ufrs12/OLTA-PCB-ROLL-CUTTER/3d/cutter/Подшипник 608.FCStd

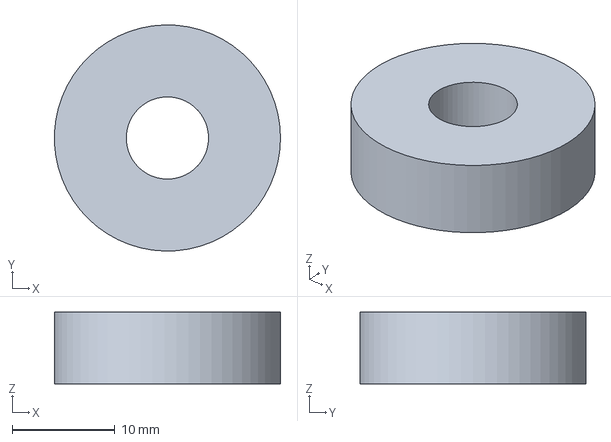
[picture p9: CAD file, 2025-05-30]
3d/cutter/Подшипник 608.FCStd
22.0 x 22.0 x 7.00 mm
