ufrs12/OLTA-PCB-ROLL-CUTTER/3d/machine/Опора.FCStd

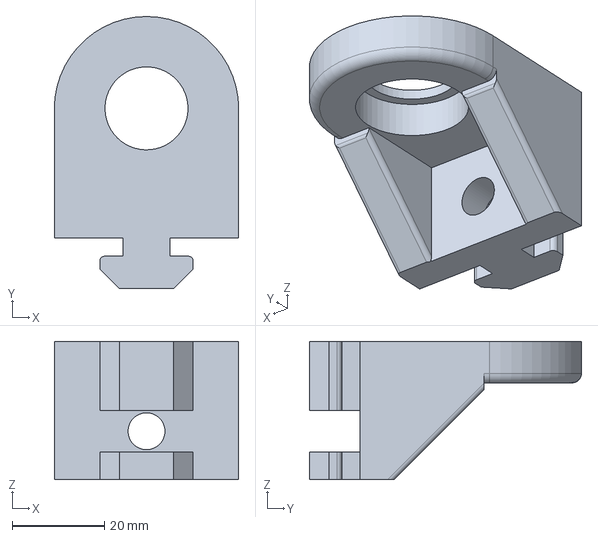
[picture p10: CAD file, 2025-05-30]
3d/machine/Опора.FCStd
40.0 x 59.0 x 30.0 mm
