ufrs12/OLTA-PCB-ROLL-CUTTER/3d/cutter/Тюрючек.FCStd

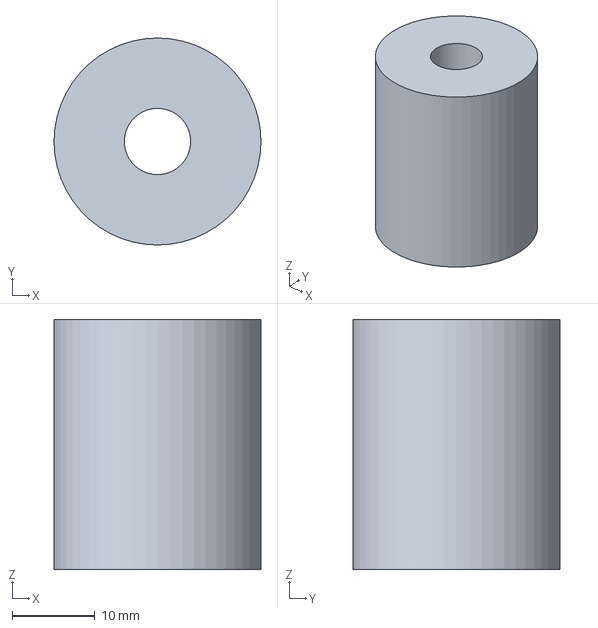
[picture p11: CAD file, 2025-05-30]
3d/cutter/Тюрючек.FCStd
25.0 x 25.0 x 30.2 mm
