ufrs12/OLTA-PCB-ROLL-CUTTER/3d/cutter/Прижим лезвия.FCStd

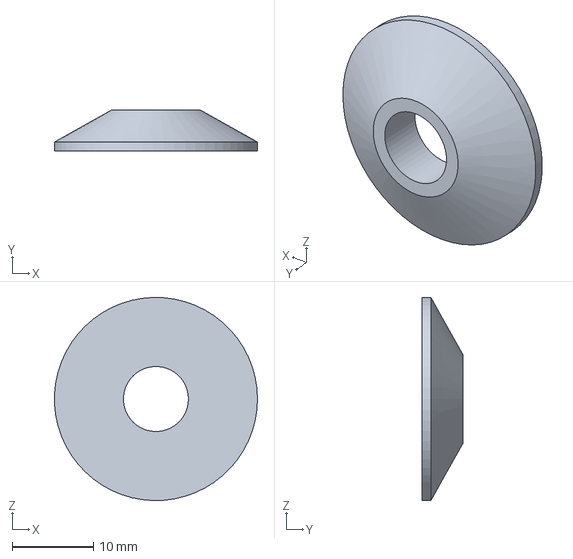
[picture p12: CAD file, 2025-05-30]
3d/cutter/Прижим лезвия.FCStd
25.0 x 5.00 x 25.0 mm
