ufrs12/OLTA-PCB-ROLL-CUTTER/3d/cutter/Лезвие.FCStd

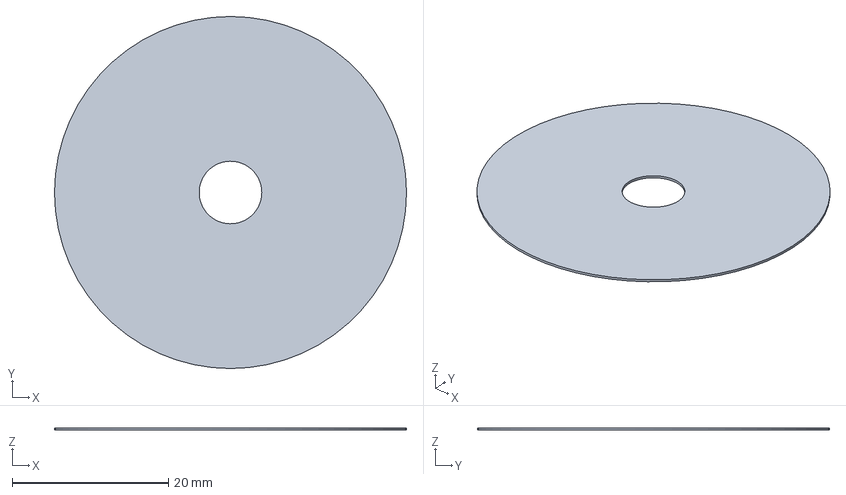
[picture p13: CAD file, 2025-05-30]
3d/cutter/Лезвие.FCStd
45.0 x 45.0 x 0.3 mm
