ufrs12/OLTA-PCB-ROLL-CUTTER/3d/cutter/Стойка.FCStd

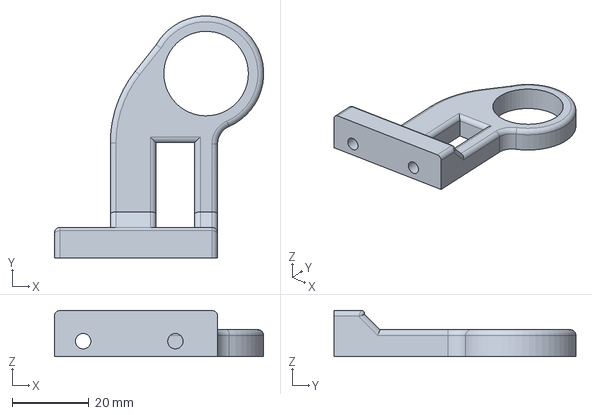
[picture p14: CAD file, 2025-05-30]
3d/cutter/Стойка.FCStd
54.5 x 63.0 x 12.0 mm
