ufrs12/OLTA-PCB-ROLL-CUTTER/3d/cutter/Сборка.FCStd

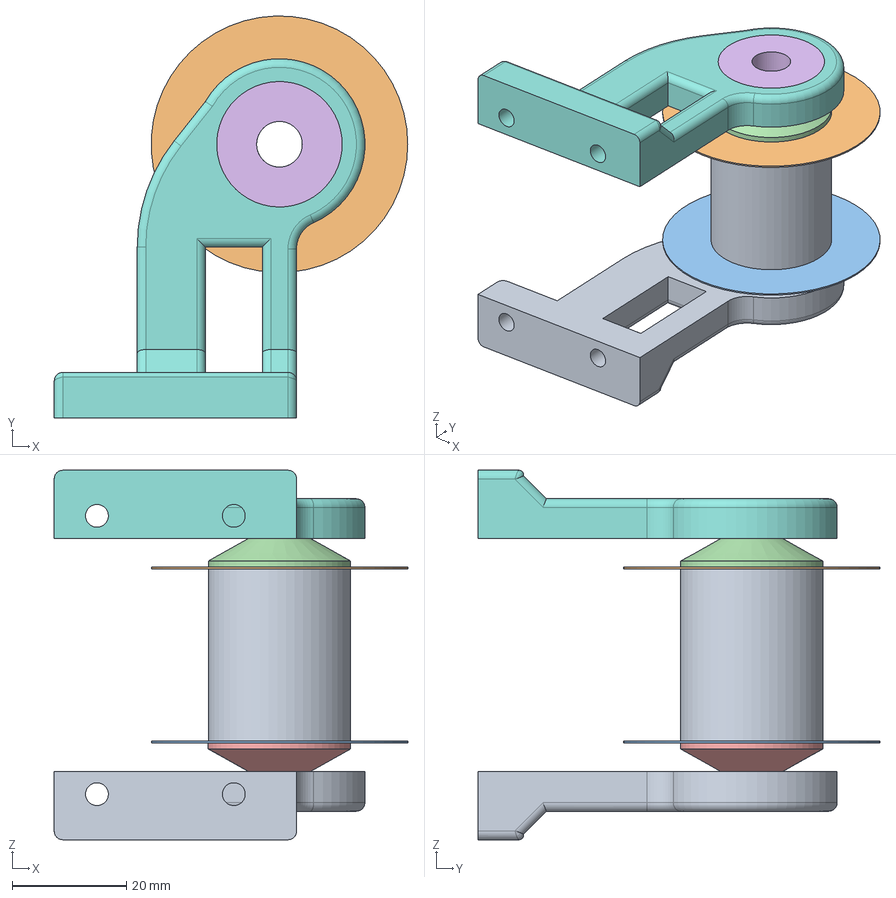
[picture p15: CAD file, 2025-05-30]
3d/cutter/Сборка.FCStd
62.0 x 70.5 x 64.8 mm
Тюрючек_001
Лезвие_001
Лезвие_002
Прижим лезвия_002
Прижим лезвия_001
Подшипник 608_001
Подшипник 608_002
Стойка_001
Стойка_001 (Mirror #1)
